SamuelKacej/aDual-Micromouse/README.md

# aDual-Micromouse
Micromouse robot based on STM32F405
https://youtu.be/BUGs1UDPQn8
