SamuelKacej/aDual-Micromouse/PCB/Micromouse-aDual.pdf

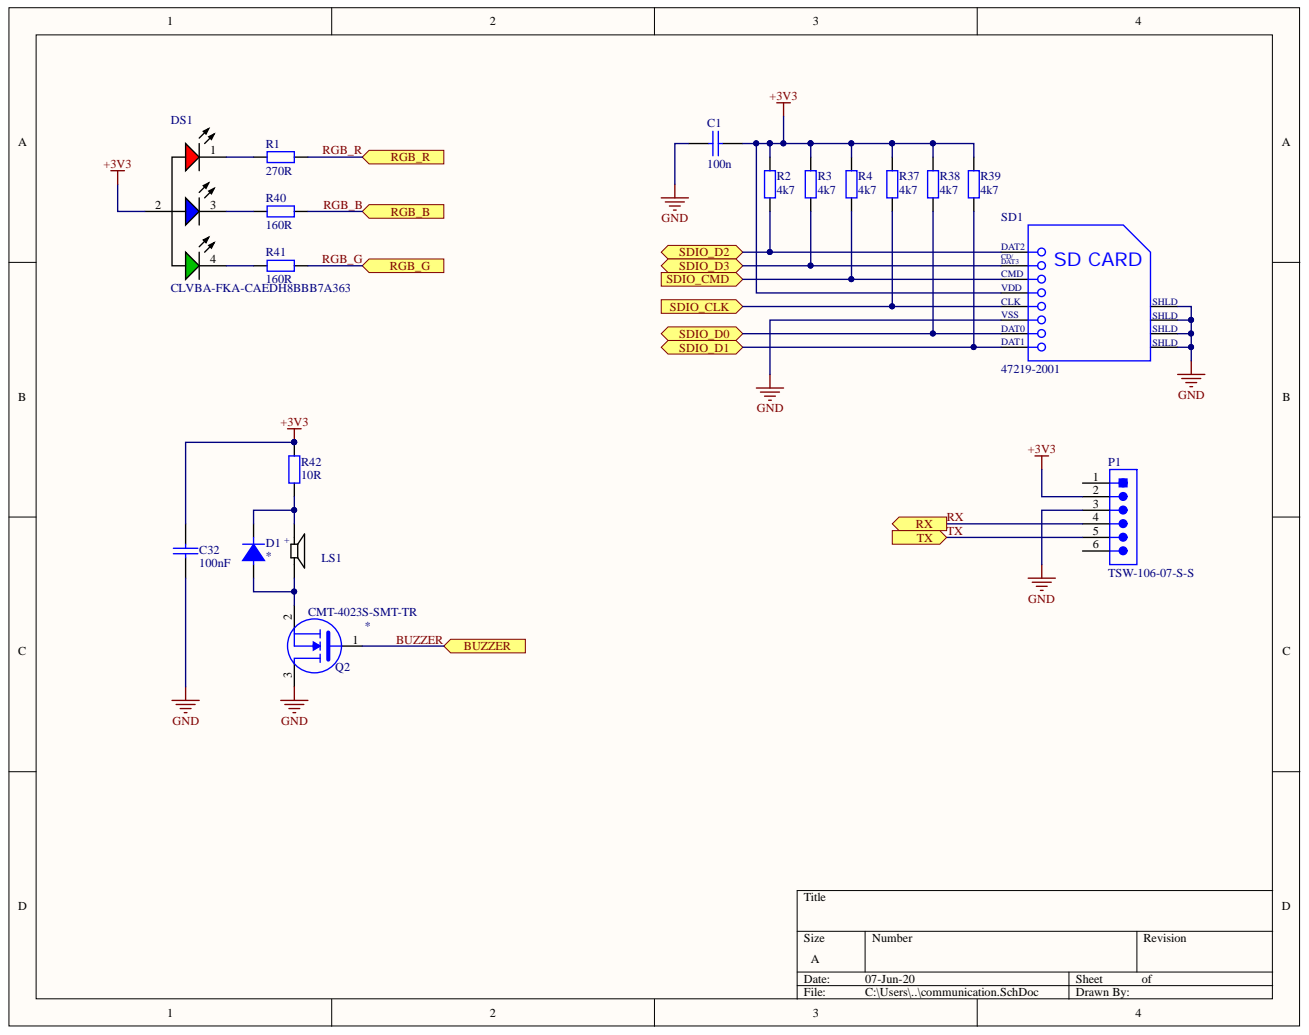
[picture p1: page 1]

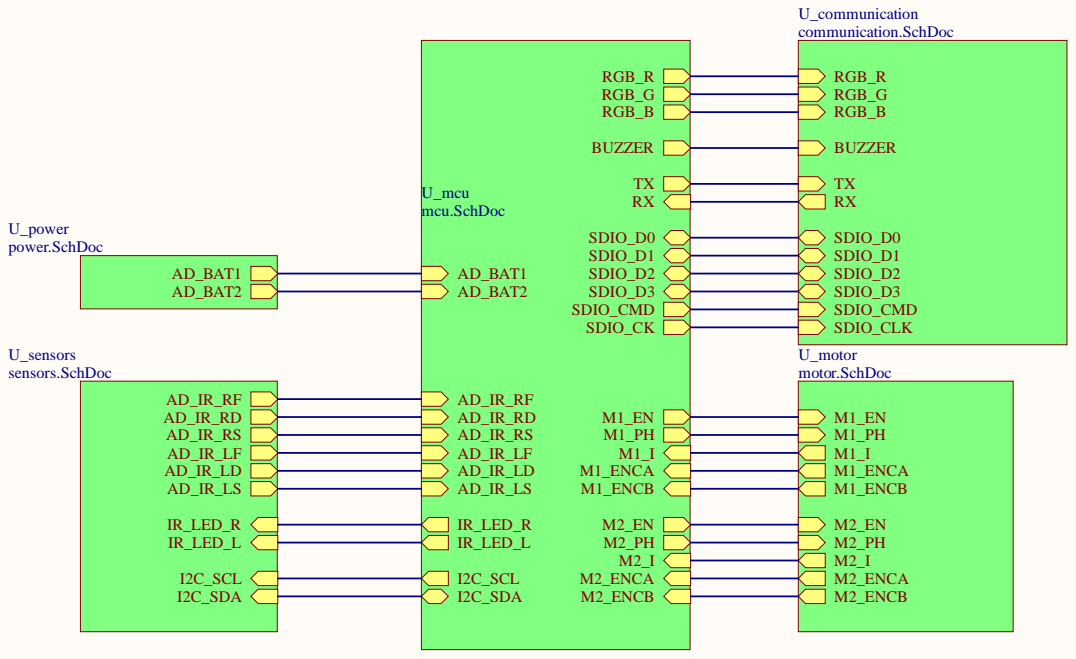
[picture p2: page 2]

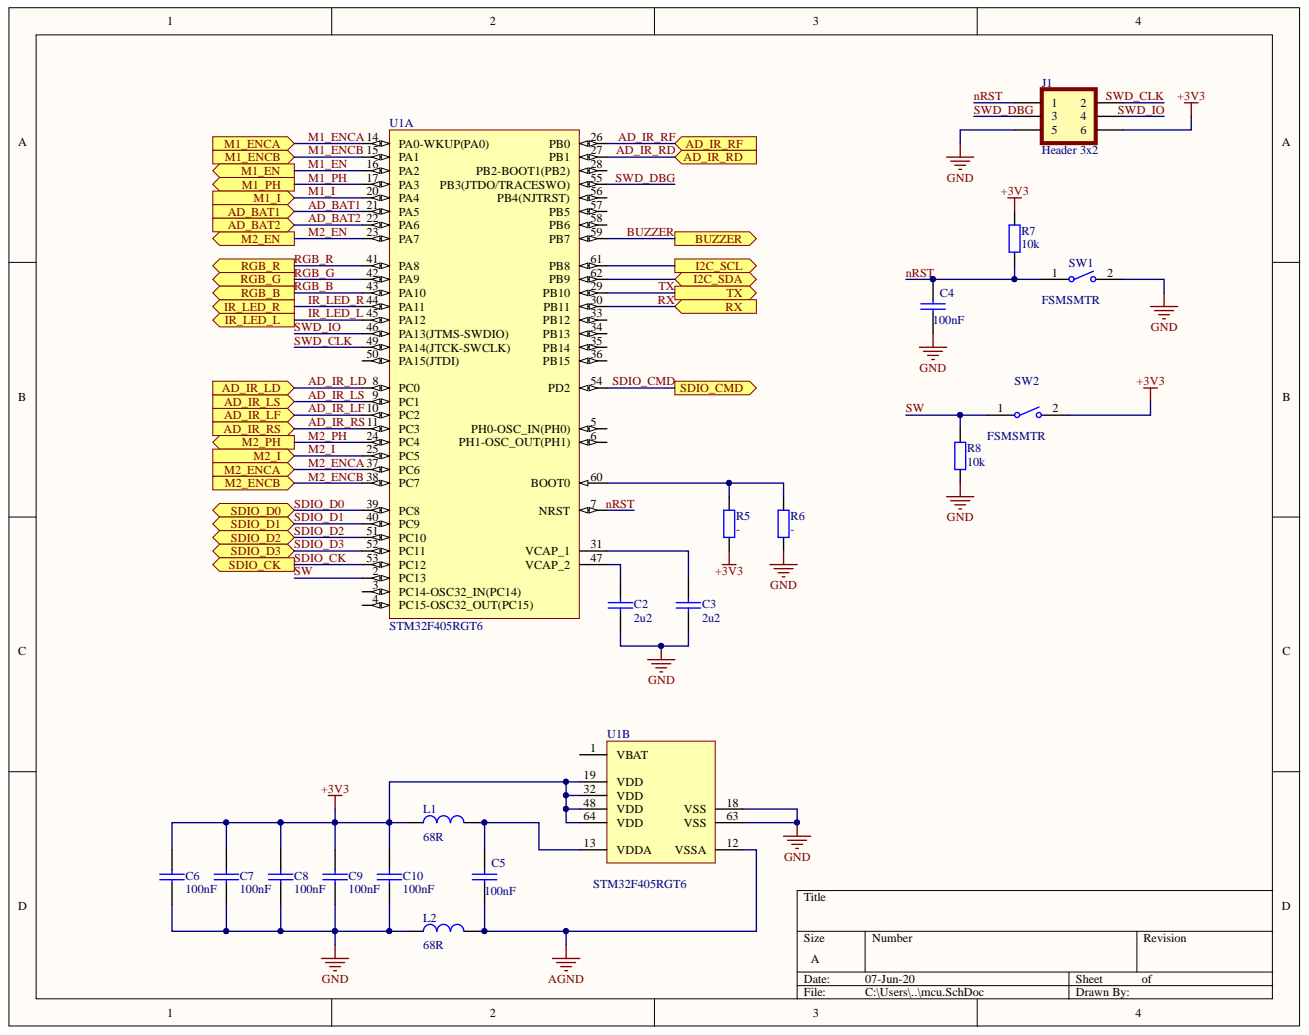
[picture p3: page 3]

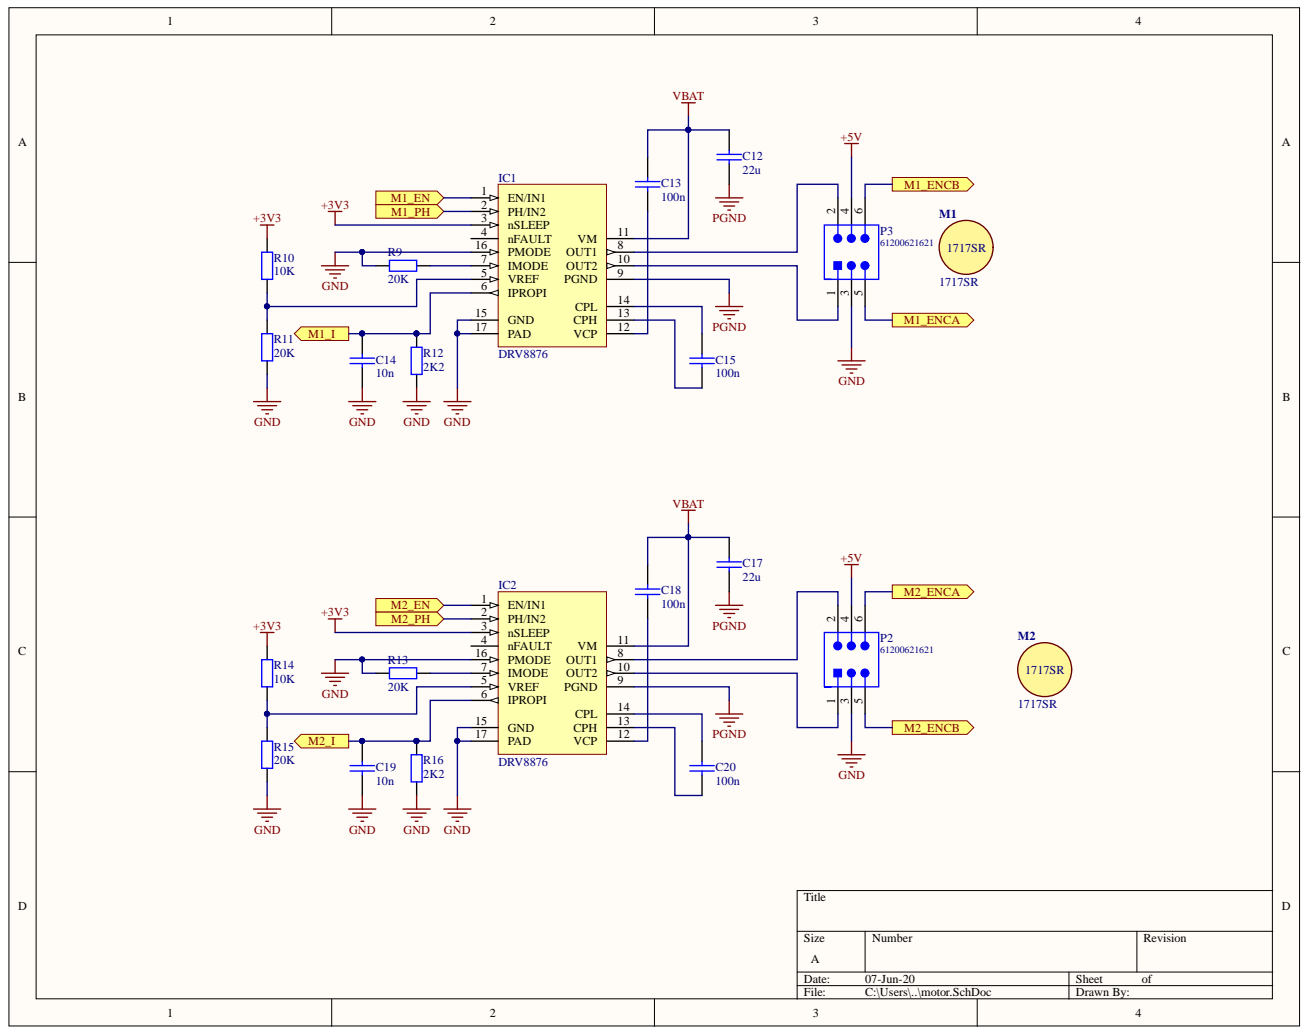
[picture p4: page 4]

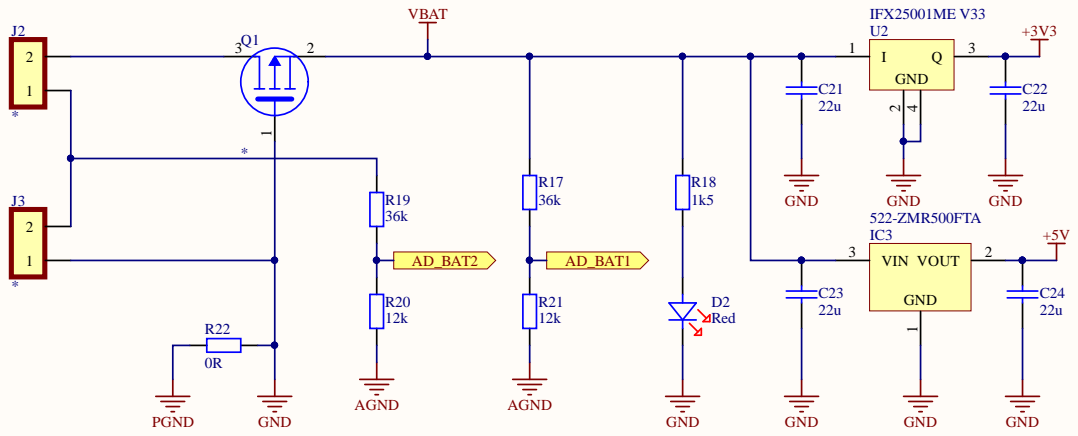
[picture p5: page 5]

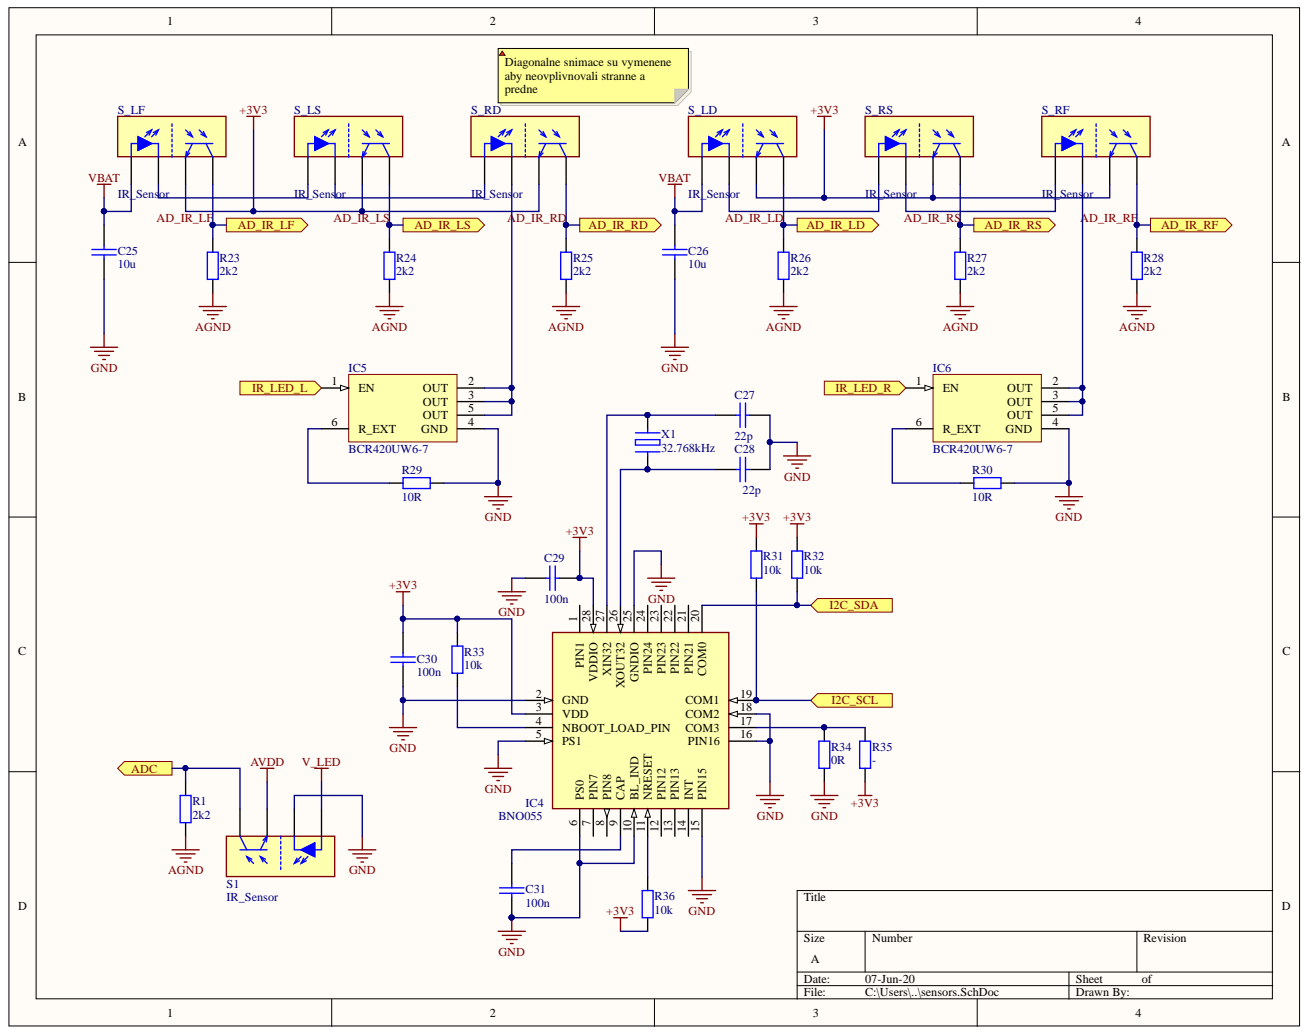
[picture p6: page 6]

Diagonalne snimace su vymenene
aby neovplivnovali stranne a
predne

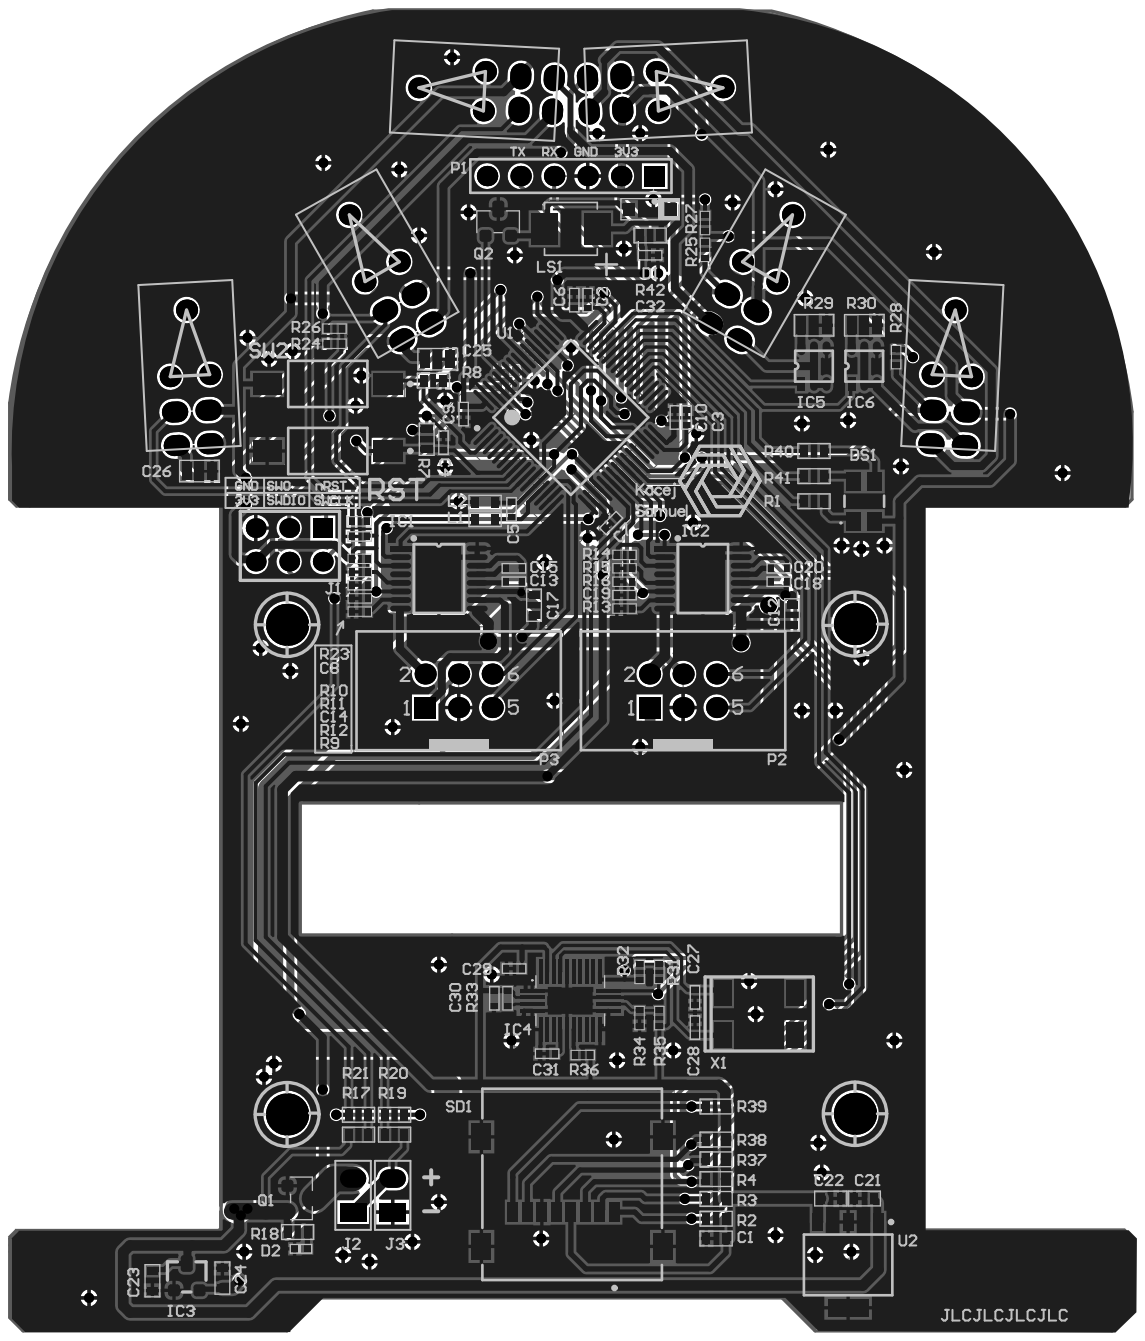
[picture p7: page 7]

# Board Stack Report
