SamuelKacej/aDual-Micromouse/(list of files, drawings)

Other design files:
PCB/communication.SchDoc
PCB/Hierarchi.SchDoc
PCB/mcu.SchDoc
PCB/Micromouse-aDual.PrjPcb
PCB/motor.SchDoc
PCB/power.SchDoc
PCB/sensors.SchDoc
