SamuelKacej/aDual-Micromouse/Software/aDual2/Src/main.c

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
/* Includes ------------------------------------------------------------------*/
#include "main.h"
#include "adc.h"
#include "dma.h"
//#include "fatfs.h"
#include "i2c.h"
//#include "sdio.h"
#include "tim.h"
#include "usart.h"
#include "gpio.h"

/* USER CODE BEGIN Includes */
//#include "MY_FLASH.h"
#include "sensors.h"
#include "maze.h"
#include "actuator.h"
#include "motor.h"
#include "motionSystem.h"
#include "BNO055.h"
#include "mouse.h"
#include "mapping.h"
/* USER CODE END Includes */

/* USER CODE BEGIN PD */
uint8_t vTest;
/* USER CODE END PD */

/* USER CODE BEGIN PM */
void MAIN_SetPIDs(){

	MOTOR_ControllerSet( &MOTOR_currentController[0], 0.1, 15, 0);
	MOTOR_currentController[0].b = 1;	// source of P error variable
	MOTOR_currentController[0].c = 1;
	MOTOR_currentController[0].feedfwd_0order_K = 0.01;
	MOTOR_currentController[0].feedfwd_1order_K = 0;
	MOTOR_currentController[0].feedfwd_1order_T = 0;

	MOTOR_ControllerSet( &MOTOR_currentController[1], 0.1, 15, 0);
	MOTOR_currentController[1].b = 1;	// source of P error variable
	MOTOR_currentController[1].c = 1;
	MOTOR_currentController[1].feedfwd_0order_K = 0.01;
	MOTOR_currentController[1].feedfwd_1order_K = 0;
	MOTOR_currentController[1].feedfwd_1order_T = 0;


	// velocity										   3e-7, 2e-6, 0
	MOTOR_ControllerSet( &MOTOR_velocityController[1], 3e-6, 1e-5, 0);
	MOTOR_velocityController[1].b = 1;
	MOTOR_velocityController[1].c = 1;
	MOTOR_velocityController[1].feedfwd_0order_K = 3e-7;
	MOTOR_velocityController[1].feedfwd_1order_K = 4e-8;
	MOTOR_velocityController[1].feedfwd_1order_T = 0.02;


	MOTOR_ControllerSet( &MOTOR_velocityController[0], 3e-6, 1e-5, 0);
	MOTOR_velocityController[0].b = 1;
	MOTOR_velocityController[0].c = 1;
	MOTOR_velocityController[0].feedfwd_0order_K = 3e-7;
	MOTOR_velocityController[0].feedfwd_1order_K = 4e-8;
	MOTOR_velocityController[0].feedfwd_1order_T = 0.02;


// vector velocity
  MOTION_Init(1, 0, 0,  0, 1, 0);

}
/* USER CODE END PM */


void SystemClock_Config(void);
/* USER CODE BEGIN 0 */

	uint16_t val = 0;
	volatile uint32_t MAIN_tmp;
	float transV = 0; // mm/s
	float angularV = 0 ; 	//rad/s

   // volatile uint32_t MAIN_tPeriod;


#define PUTCHAR_PROTOTYPE int fputc(int ch, FILE *f)
int _write(int file, char* data, int len){
	 // arbitrary timeout 1000
	   HAL_StatusTypeDef status =
		  HAL_UART_Transmit(&huart3, (uint8_t*)data, len, 1000);

	   // return # of bytes written - as best we can tell
	   return (status == HAL_OK ? len : 0);
}


/* USER CODE END 0 */

/**
  * @brief  The application entry point.
  * @retval int
  */
int main(void)
{
  /* MCU Configuration--------------------------------------------------------*/

  /* Reset of all peripherals, Initializes the Flash interface and the Systick. */
   HAL_Init();

  /* Configure the system clock */
  SystemClock_Config();

  /* Initialize all configured peripherals */
  MX_GPIO_Init();
  MX_DMA_Init();
 // MX_SDIO_SD_Init();
 // MX_FATFS_Init();
  MX_ADC1_Init();
  MX_ADC2_Init();
  MX_ADC3_Init();
  MX_I2C1_Init();
  MX_TIM1_Init();
  MX_TIM3_Init();
  MX_TIM4_Init();
  MX_TIM5_Init();
  MX_USART3_UART_Init();
  MX_TIM9_Init();
  MX_TIM14_Init();
  MX_TIM2_Init();
  MX_TIM12_Init();
  /* USER CODE BEGIN 2 */


  HAL_TIM_Base_Start_IT(&htim2);// microSeconds timmer

  // INIT LBRS
  MAIN_tStart = 0;
  MAIN_seconds= 0;
  SENSORS_Init();
  ACTUATOR_Init();

  // INIT is ok
  ACTUATOR_LED(200, 0, 0);
  HAL_Delay(200);
  ACTUATOR_LED(0, 0, 0);



  MAZE_ClearMaze(MAZE_maze);
  CMD_clearList();

  // INIT CONTROLLERS

  // INIT PERIODIC TIMMERS

  HAL_Delay(500);

  MOTOR_INIT();
  MAIN_SetPIDs();
  HAL_TIM_Base_Start_IT(&htim12);// 2.5ms periodic timmer for controller update

   ACTUATOR_LED(0, 120, 0);
   HAL_Delay(200);
   ACTUATOR_LED(0, 0, 0);


  /* USER CODE END 2 */

  /* Infinite loop */
  /* USER CODE BEGIN WHILE */

	MOTOR_SetVoltage(1, 0);
	MOTOR_SetVoltage(0, 0);




  volatile uint32_t tStart = MAIN_GetMicros();

  MOUSE_CellPosition = 0;
  MOUSE_CellOrientation = ROT_NORTH;

  while (1)
  {

	  HAL_Delay(1e3);

	  if(SENSORS_batteryV[0] < 7200){
	  	  		  //3.6V per cell

	  	  while(1){

	  		HAL_TIM_Base_Stop_IT(&htim12);

			  MOTOR_SetVoltage(1, 0);
			  MOTOR_SetVoltage(0, 0);

			  // start blinking red LED
			  ACTUATOR_LED(0, 0, 0);
			  HAL_Delay(100);
			  ACTUATOR_LED(50, 0, 0);
			  HAL_Delay(20);

	  	  }
	    	  }




	  ACTUATOR_LED(0, 0, 150);
	  HAL_Delay(1500);
	  ACTUATOR_LED(0, 0, 0);
	  HAL_Delay(100);

	  MOUSE_Test();


 	  MOUSE_SearchRun(500, 0x00, 0x62);
	  HAL_Delay(500);

	  MOUSE_SearchRun(450.0, MOUSE_CellPosition, 0x00);
	  HAL_Delay(3500);

	  MOUSE_SpeedRun(1200.0, MOUSE_CellPosition, 0x62);

	  HAL_Delay(500);

	  MOUSE_SearchRun(450.0, MOUSE_CellPosition, 0x00);
	  HAL_Delay(500);

	  MOUSE_SpeedRun(1200.0, MOUSE_CellPosition, 0x62);


	//  HAL_TIM_Base_Stop_IT(&htim12);
	  MOTOR_SetVoltage(1, 0);
	  MOTOR_SetVoltage(0, 0);

	  tStart = MAIN_GetMicros() ;
  	  while(tStart+1e7 > MAIN_GetMicros()){
		  ACTUATOR_LED(-1, -1, 100);
		  HAL_Delay(250);
		  ACTUATOR_LED(-1, -1, 0);
		  HAL_Delay(250);
		  }
  	//HAL_TIM_Base_Start_IT(&htim12);


    /* USER CODE END WHILE */

    /* USER CODE BEGIN 3 */
  }
  /* USER CODE END 3 */
}

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
/* USER CODE BEGIN 4 */
volatile uint32_t MAIN_GetMicros(){
	return (uint32_t)htim2.Instance->CNT + (uint32_t)MAIN_seconds*htim2.Init.Period;
}

void HAL_TIM_PeriodElapsedCallback(TIM_HandleTypeDef *htim)
{
  /* Prevent unused argument(s) compilation warning */
  UNUSED(htim);

  /* NOTE : This function should not be modified, when the callback is needed,
            the HAL_TIM_PeriodElapsedCallback could be implemented in the user file
   */

  //static float speed = 0;

  if(htim->Instance == htim12.Instance){

	  //TODO  battery chcek
	  //	  volatile int sTime = MAIN_GetMicros();

	  //if(MAIN_GetMicros()>3e6)  speed = 4;
	  //if(MAIN_GetMicros()>5e6)  HAL_TIM_Base_Stop_IT(&htim12);
	 // MOTION_SetVelocity(0, 6);
	  //speed += 0.005;



	  MOTION_Update();
	  SENSORS_Update(); // 140 us

	  // printf("%.3f, %.3f\r\n", SENSORS_angleVel, speed);

	  // printf("%f, %f\r\n", MOTOR_velocityController[0].FB, MOTOR_velocityController[1].FB);





  } else if(htim->Instance == htim2.Instance)
	  MAIN_seconds++;
  else  if(htim->Instance == SENSORS_HTIM_ENC_L.Instance || \
		   htim->Instance == SENSORS_HTIM_ENC_R.Instance)
	  SENSORS_EncoderTimCallback(htim);

}

void HAL_ADC_ConvCpltCallback(ADC_HandleTypeDef* hadc)
{
  /* Prevent unused argument(s) compilation warning */
  UNUSED(hadc);
  /* NOTE : This function Should not be modified, when the callback is needed,
            the HAL_ADC_ConvCpltCallback could be implemented in the user file
   */


  SENSORS_AdcCallback(hadc);


}


/* USER CODE END 4 */
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
