SamuelKacej/aDual-Micromouse/Software/aDual2/aDual2.ioc

Mcu.UserName=STM32F405RGTx
PA0-WKUP.GPIO_Label=TIM5_CH1_ENC1_A
PA0-WKUP.Signal=S_TIM5_CH1
PA1.GPIO_Label=TIM5_CH2_ENC1_B
PA1.Signal=S_TIM5_CH2
PA10.GPIO_Label=TIM1_RGB_B
PA10.Signal=S_TIM1_CH3
PA11.GPIO_Label=GPIO_IR_LED2
PA11.Signal=GPIO_Output
PA12.GPIO_Label=GPIO_IR_LED1
PA12.Signal=GPIO_Output
PA13.Signal=SYS_JTMS-SWDIO
PA14.Signal=SYS_JTCK-SWCLK
PA2.GPIO_Label=M1_EN
PA2.Signal=S_TIM9_CH1
PA3.GPIO_Label=M1_DIR
PA3.Signal=GPIO_Output
PA4.GPIO_Label=M1_ISENSE
PA4.Signal=ADCx_IN4
PA5.GPIO_Label=ADC_BAT1
PA5.Signal=ADCx_IN5
PA6.GPIO_Label=ADC_BAT2
PA6.Signal=ADCx_IN6
PA7.GPIO_Label=M2_EN
PA7.Signal=S_TIM14_CH1
PA8.GPIO_Label=TIM1_RGB_R
PA8.Signal=S_TIM1_CH1
PA9.GPIO_Label=TIM1_RGB_G
PA9.Signal=S_TIM1_CH2
PB0.GPIO_Label=ADC_IR_RF
PB0.Signal=ADCx_IN8
PB1.GPIO_Label=ADC_IR_RD
PB1.Signal=ADCx_IN9
PB10.Signal=USART3_TX
PB11.Signal=USART3_RX
PB15.GPIO_Label=SDIO_SW
PB15.Signal=GPIO_Input
PB3.Signal=SYS_JTDO-SWO
PB7.GPIO_Label=TIM4_BUZZER
PB7.Signal=S_TIM4_CH2
PB8.Signal=I2C1_SCL
PB9.Signal=I2C1_SDA
PC0.GPIO_Label=ADC_IR_LD
PC0.Signal=SharedAnalog_PC0
PC1.GPIO_Label=ADC_IR_LS
PC1.Signal=SharedAnalog_PC1
PC10.Signal=SDIO_D2
PC11.Signal=SDIO_D3
PC12.Signal=SDIO_CK
PC13-ANTI_TAMP.GPIO_Label=GPIO_SW
PC13-ANTI_TAMP.Signal=GPXTI13
PC2.GPIO_Label=ADC_IR_LF
PC2.Signal=ADCx_IN12
PC3.GPIO_Label=ADC_IR_RS
PC3.Signal=SharedAnalog_PC3
PC4.GPIO_Label=M2_DIR
PC4.Signal=GPIO_Output
PC5.GPIO_Label=M2_ISENSE
PC5.Signal=ADCx_IN15
PC6.GPIO_Label=TIM3_CH1_ENC2_A
PC6.Signal=S_TIM3_CH1
PC7.GPIO_Label=TIM3_CH2_ENC2_B
PC7.Signal=S_TIM3_CH2
PC8.Signal=SDIO_D0
PC9.Signal=SDIO_D1
PD2.Signal=SDIO_CMD
