SamuelKacej/aDual-Micromouse/Software/aDual2/Inc/mapping.h

/*
 * mapping.h
 *
 *  Created on: Feb 9, 2021
 *      Author: samok
 */

#ifndef MAPPING_H_
#define MAPPING_H_

#include "main.h"
#include "instructions.h"
#include "command.h"
#include "maze.h"
#include "motionSystem.h"
#include "stdio.h"
#include "usart.h"

#define MAPPING_WALL_TRESHOLD_FRONT1 100 //mm - one of them must be less then this value
#define MAPPING_WALL_TRESHOLD_FRONT2 115 //mm - avearage value from both sensors mus be less the this value
#define MAPPING_WALL_TRESHOLD_SIDE 95//85  //mm

uint8_t MAPPING_isTimeToReadSideWall();

uint8_t MAPPING_isTimeToReadFrontWall();

uint8_t MAPPING_WriteWalls(CMD_WALLS_RELATIVE wall,uint8_t pos, MAZE_ABSOLUTE_DIRECTION_T absOrientation);

uint8_t MAPPING_LookForWalls( uint8_t sensorSelect);

uint8_t MAPPING_isPositionForSideCorrection();


void MAPPING_PrintMaze(uint16_t mousePos);

#endif /* MAPPING_H_ */
