SamuelKacej/aDual-Micromouse/(commit log)

2020-06-11 add PCB layout
    [Hierarchi.SchDoc, Micromouse-aDual.PrjPcb, communication.SchDoc, mcu.SchDoc, motor.SchDoc, power.SchDoc, sensors.SchDoc]
2021-02-01 new InstrList
    Two 32 parallel instruction list were replaced by signle instruction 256 element list
    [aDual2.ioc, adc.c, command.c, command.h, fatfs_platform.h, instructions.c]
2021-02-04 update of search function
    Problem in wall detection was solved,
    wall is writen to both cells from both side of wall.
    During FWD is activated PD controller of wall following to corret orientation.
    [MY_FLASH.h, command.c, instructions.c, main.c, maze.c, maze.h, motionSystem.c, mouse.c]
2021-02-10 Search run is fully working
    -added side corection
    -added front wall corection at stop
    -mapping is working
    Problems around inplace turn was solved by puting battery in front of motors => so center of gravity is more in front => so front wheels are dominant
    [BNO055.c, command.c, correction.c, correction.h, instructions.c, instructions.h, main.c, mapping.c]
2021-02-17 backup
    ff is not working controller is not very robust
    [aDual2.ioc, actuator.c, actuator.h, command.c, main.c, main.h, motionSystem.c]
2021-02-17 FF implemented
    feed forward was implemented and tuned for velocity controller. Also was added simple adaptive controller for angular velocity.
    TODO: speed up IP turn
2021-04-03 Istrobot 2021 version
    correction tuned
    [BNO055.c, command.c, correction.c, correction.h, instructions.c, instructions.h, main.c, mapping.c]
